leobeo-png/Luminas/README.md

# Luminas
Rhythm game controller development. <br>
[Video Demo](https://www.youtube.com/watch?v=vNHZUSEBsMY "Early Prototype")
[Video Demo](https://www.youtube.com/watch?v=JDYHQ-9xTno "Prototype Update")
---
## Description
 - Custom keyboard NKRO HID 
 - PCB size for 15.6" laptop
 - Separate I2C Bus for the capacitive touch and time of flight to reduce load
---
## Components Used:
 - STM32F411CEU6
 - MPR121 Modules x3
 - VL53L0X ToF sensors x2 (x4 in the future)
 - TCA9548 I2C Multiplexer
 - Pull-up resistors
---
## Goals
 - Improve the design of the PCB 
 - Reaserch and design the casing
--- 
## What I Learnt so Far 
 - HID (descriptors, how NKRO works)
 - PCB schematic designing
 - Diving further into I2C
