leobeo-png/Luminas/sch/sch.kicad_pcb

## KiCad design sch/sch.kicad_pcb (2026-06-11)

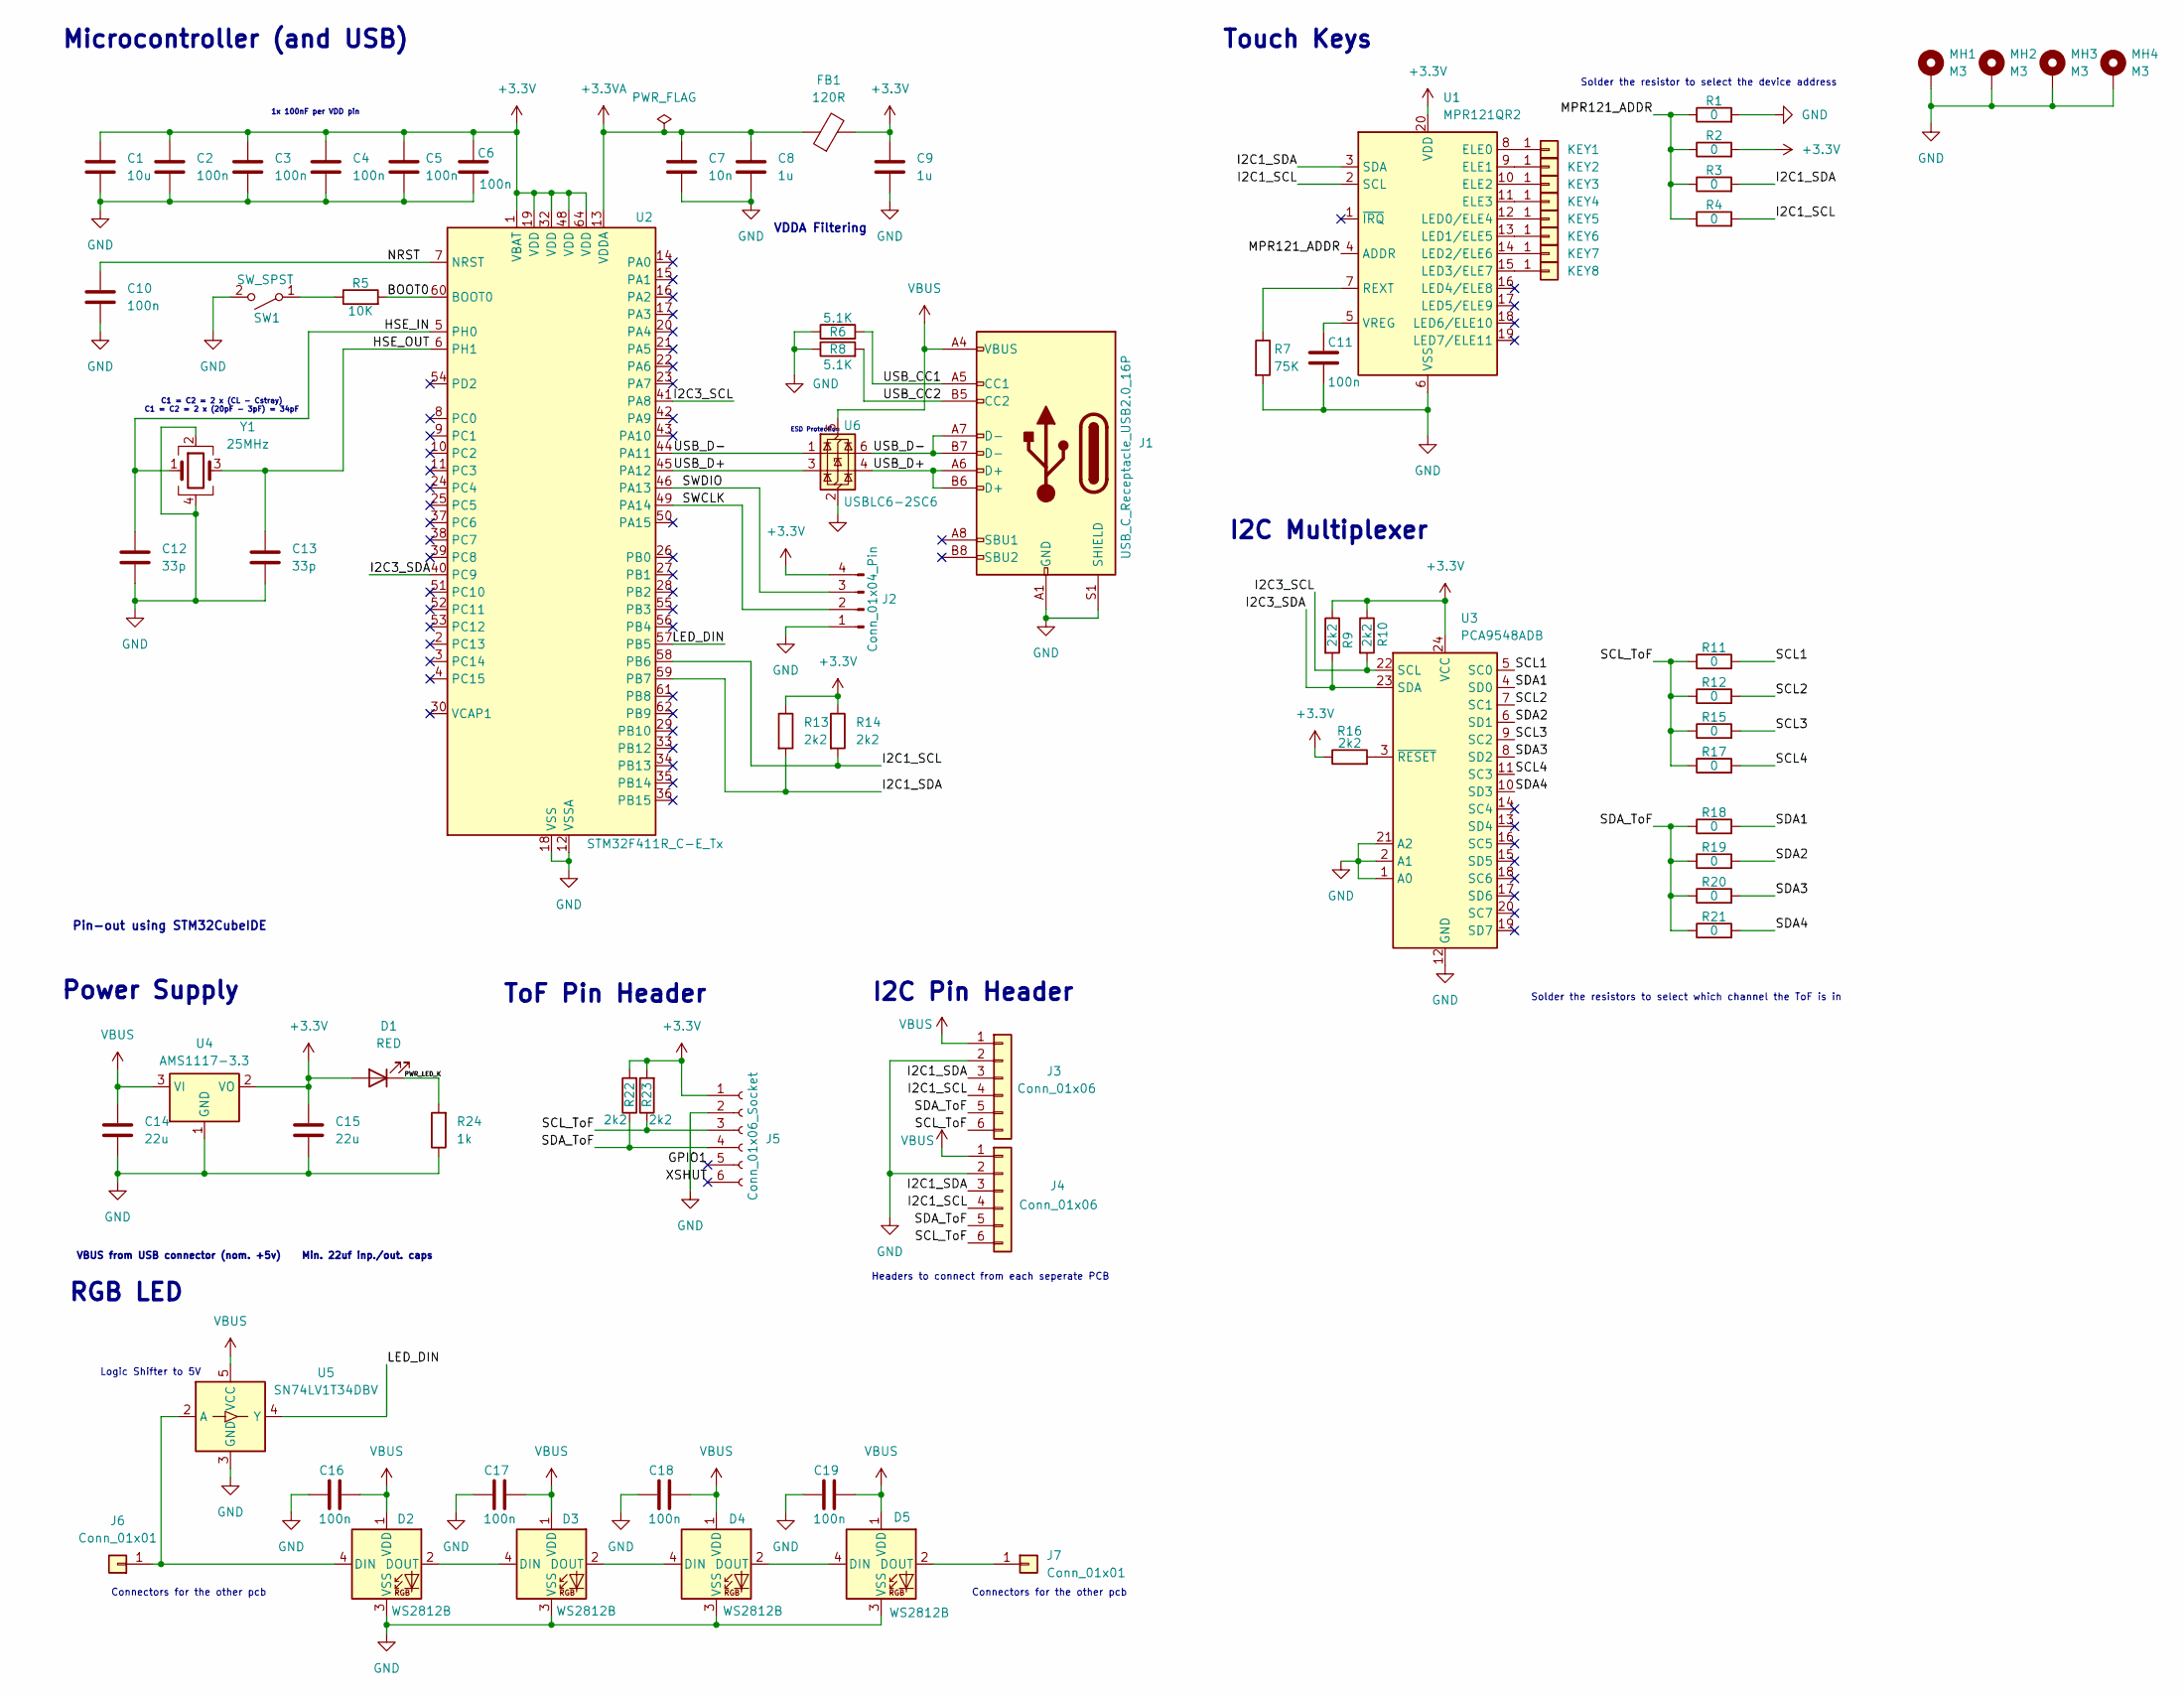
[picture p1: schematic sch.kicad_sch, Chunithm_Luminas]

Parts:
C1: 10u; C_0603_1608Metric_Pad1.08x0.95mm_HandSolder
C2, C3, C4, C5, C6, C10, C11, C16, C17, C18, C19: 100n; C_0603_1608Metric_Pad1.08x0.95mm_HandSolder
C7: 10n; C_0603_1608Metric_Pad1.08x0.95mm_HandSolder
C8, C9: 1u; C_0603_1608Metric_Pad1.08x0.95mm_HandSolder
C12, C13: 33p; C_0603_1608Metric_Pad1.08x0.95mm_HandSolder
C14, C15: 22u; C_0805_2012Metric
D1: RED; LED_0201_0603Metric
D2, D3, D4, D5: WS2812B; LED_WS2812B_PLCC4_5.0x5.0mm_P3.2mm
FB1: 120R; L_0603_1608Metric
J1: USB_C_Receptacle_USB2.0_16P; USB_C_Receptacle_GCT_USB4105-xx-A_16P_TopMnt_Horizontal
J2: Conn_01x04_Pin; PinHeader_1x04_P2.54mm_Vertical
J3, J4: Conn_01x06; Conn_Solder_I2C
J5: Conn_01x06_Socket; PinHeader_1x06_P2.54mm_Vertical
J6, J7: Conn_01x01; Solder_3P
KEY1, KEY2, KEY3, KEY4, KEY5, KEY6, KEY7, KEY8: Conn_01x01; ChuKey
MH1, MH2, MH3, MH4: M3; MountingHole_3.2mm_M3_Pad_Via
R1, R2, R3, R4, R11, R12, R15, R17, R18, R19, R20, R21: 0; R_0603_1608Metric_Pad0.98x0.95mm_HandSolder
R5: 10K; R_0603_1608Metric_Pad0.98x0.95mm_HandSolder
R6, R8: 5.1K; R_0603_1608Metric_Pad0.98x0.95mm_HandSolder
R7: 75K; R_0603_1608Metric_Pad0.98x0.95mm_HandSolder
R9, R10, R13, R14, R16, R22, R23: 2k2; R_0603_1608Metric_Pad0.98x0.95mm_HandSolder
R24: 1k; R_0603_1608Metric_Pad0.98x0.95mm_HandSolder
SW1: SW_SPST; SW_SPST_TS-1088-xR025
U1: MPR121QR2; UQFN-20_3x3mm_P0.4mm
U2: STM32F411R_C-E_Tx; LQFP-64_10x10mm_P0.5mm
U3: PCA9548ADB; TSSOP-24_4.4x7.8mm_P0.65mm
U4: AMS1117-3.3; SOT-223-3_TabPin2
U5: SN74LV1T34DBV; SOT-23-5
U6: USBLC6-2SC6; SOT-23-6
Y1: 25MHz; Crystal_SMD_3225-4Pin_3.2x2.5mm_HandSoldering

Connections:
+3.3V: C1.1, C2.1, C3.1, C4.1, C5.1, C6.1, C9.1, C15.1, D1.2 (A), FB1.2, J2.4, J5.1, R2.2, R9.1, R10.1, R13.1, R14.1, R16.1, R22.2, R23.2, U1.20 (VDD), U2.1 (VBAT), U2.19 (VDD), U2.32 (VDD), U2.48 (VDD), U2.64 (VDD), U3.24 (VCC), U4.2 (VO)
+3.3VA: C7.1, C8.1, FB1.1, U2.13 (VDDA)
/BOOT0: R5.2, U2.60 (BOOT0)
/GPIO1: J5.5
/HSE_IN: C12.1, U2.5 (PH0), Y1.1
/HSE_OUT: C13.1, U2.6 (PH1), Y1.3
/I2C1_SCL: J3.4, J4.4, R4.2, R14.2, U1.2 (SCL), U2.58 (PB6)
/I2C1_SDA: J3.3, J4.3, R3.2, R13.2, U1.3 (SDA), U2.59 (PB7)
/I2C3_SCL: R10.2, U2.41 (PA8), U3.22 (SCL)
/I2C3_SDA: R9.2, U2.40 (PC9), U3.23 (SDA)
/LED_DIN: U2.57 (PB5), U5.4 (Y)
/MPR121_ADDR: R1.1, R2.1, R3.1, R4.1, U1.4 (ADDR)
/NRST: C10.1, U2.7 (NRST)
/PWR_LED_K: D1.1 (K), R24.2
/SCL1: R11.2, U3.5 (SC0)
/SCL2: R12.2, U3.7 (SC1)
/SCL3: R15.2, U3.9 (SC2)
/SCL4: R17.2, U3.11 (SC3)
/SCL_ToF: J3.6, J4.6, J5.3, R11.1, R12.1, R15.1, R17.1, R23.1
/SDA1: R18.2, U3.4 (SD0)
/SDA2: R19.2, U3.6 (SD1)
/SDA3: R20.2, U3.8 (SD2)
/SDA4: R21.2, U3.10 (SD3)
/SDA_ToF: J3.5, J4.5, J5.4, R18.1, R19.1, R20.1, R21.1, R22.1
/SWCLK: J2.2, U2.49 (PA14)
/SWDIO: J2.3, U2.46 (PA13)
/USB_CC1: J1.A5 (CC1), R6.2
/USB_CC2: J1.B5 (CC2), R8.2
/USB_D+: J1.A6 (D+), J1.B6 (D+), U2.45 (PA12), U6.3 (I/O2), U6.4 (I/O2)
/USB_D-: J1.A7 (D-), J1.B7 (D-), U2.44 (PA11), U6.1 (I/O1), U6.6 (I/O1)
/XSHUT: J5.6
GND: C1.2, C2.2, C3.2, C4.2, C5.2, C6.2, C7.2, C8.2, C9.2, C10.2, C11.2, C12.2, C13.2, C14.2, C15.2, C16.1, C17.1, C18.1, C19.1, D2.3 (VSS), D3.3 (VSS), D4.3 (VSS), D5.3 (VSS), J1.A1 (GND), J1.A12 (GND), J1.B1 (GND), J1.B12 (GND), J1.S1 (SHIELD), J2.1, J3.2, J4.2, J5.2, MH1.1, MH2.1, MH3.1, MH4.1, R1.2, R6.1, R7.2, R8.1, R24.1, SW1.2 (B), U1.6 (VSS), U2.12 (VSSA), U2.18 (VSS), U2.31 (VSS), U2.47 (VSS), U2.63 (VSS), U3.1 (A0), U3.2 (A1), U3.12 (GND), U3.21 (A2), U4.1 (GND), U5.3 (GND), U6.2 (GND), Y1.2, Y1.4
unnamed: D2.4 (DIN), J6.1, U5.2 (A)
unnamed: D2.2 (DOUT), D3.4 (DIN)
unnamed: D3.2 (DOUT), D4.4 (DIN)
unnamed: D4.2 (DOUT), D5.4 (DIN)
unnamed: D5.2 (DOUT), J7.1
unnamed: KEY1.1, U1.8 (ELE0)
unnamed: KEY2.1, U1.9 (ELE1)
unnamed: KEY3.1, U1.10 (ELE2)
unnamed: KEY4.1, U1.11 (ELE3)
unnamed: KEY5.1, U1.12 (LED0/ELE4)
unnamed: KEY6.1, U1.13 (LED1/ELE5)
unnamed: KEY7.1, U1.14 (LED2/ELE6)
unnamed: KEY8.1, U1.15 (LED3/ELE7)
unnamed: R5.1, SW1.1 (A)
unnamed: R7.1, U1.7 (REXT)
unnamed: C11.1, U1.5 (VREG)
unnamed: R16.2, U3.3 (~RESET)
VBUS: C14.1, C16.2, C17.2, C18.2, C19.2, D2.1 (VDD), D3.1 (VDD), D4.1 (VDD), D5.1 (VDD), J1.A4 (VBUS), J1.A9 (VBUS), J1.B4 (VBUS), J1.B9 (VBUS), J3.1, J4.1, U4.3 (VI), U5.5 (VCC), U6.5 (VBUS)

Notes on the sheet:
Connectors for the other pcb
I2C Multiplexer
Solder the resistors to select which channel the ToF is in
VBUS from USB connector (nom. +5v) Min. 22uf inp./out. caps
Headers to connect from each seperate PCB
Microcontroller (and USB)
ESD Protection
VDDA Filtering
RGB LED
1x 100nF per VDD pin
I2C Pin Header
Solder the resistor to select the device address
Power Supply
Logic Shifter to 5V
Pin-out using STM32CubeIDE
Touch Keys
ToF Pin Header
C1 = C2 = 2 x (CL - Cstray) C1 = C2 = 2 x (20pF - 3pF) = 34pF

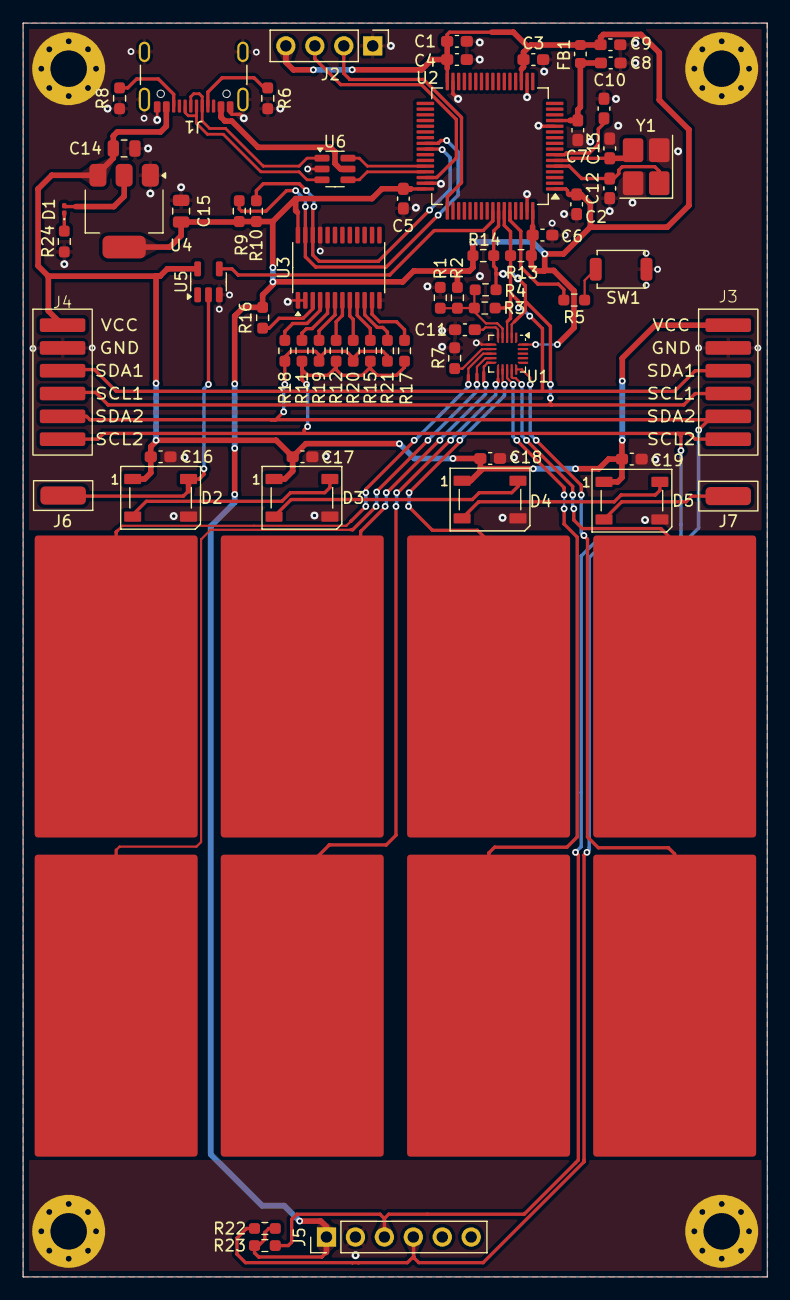
[picture p2: board sch.kicad_pcb from above]

Board: 2 copper layers, 65.3 x 110.0 mm, 76 parts (0 on the bottom side), 48 nets.
