leobeo-png/Luminas/stm32/MPR_GP2Y/MPR_GP2Y.ioc

Mcu.UserName=STM32F411CEUx
PA11.Signal=USB_OTG_FS_DM
PA12.Signal=USB_OTG_FS_DP
PA5.Signal=ADCx_IN5
PA6.Signal=ADCx_IN6
PB6.Signal=I2C1_SCL
PB7.Signal=I2C1_SDA
