leobeo-png/Luminas/stm32/MPR_GP2Y/Core/Src/main.c

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
/* Includes ------------------------------------------------------------------*/
#include "main.h"
#include "usb_device.h"

/* USER CODE BEGIN Includes */
#include "mpr121_handler.h"
#include "gp2y.h"
/* USER CODE END Includes */

ADC_HandleTypeDef hadc1;
DMA_HandleTypeDef hdma_adc1;

I2C_HandleTypeDef hi2c1;

/* USER CODE BEGIN PV */
extern uint32_t adc_buf[];
/* USER CODE END PV */

void SystemClock_Config(void);
static void MX_GPIO_Init(void);
static void MX_DMA_Init(void);
static void MX_ADC1_Init(void);
static void MX_I2C1_Init(void);
/**
  * @brief  The application entry point.
  * @retval int
  */
int main(void)
{

  /* MCU Configuration--------------------------------------------------------*/

  /* Reset of all peripherals, Initializes the Flash interface and the Systick. */
  HAL_Init();

  /* Configure the system clock */
  SystemClock_Config();

  /* Initialize all configured peripherals */
  MX_GPIO_Init();
  MX_DMA_Init();
  MX_ADC1_Init();
  MX_I2C1_Init();
  MX_USB_DEVICE_Init();
  /* USER CODE BEGIN 2 */
  //HAL_ADCEx_Calibration_start(&hadc1, ADC_CALIB_OFFSET, ADC_SINGLE_ENDED);

  GP2Y_Init();
  HAL_Delay(100);
  MPR121_Handler_Init();
  /* USER CODE END 2 */

  /* Infinite loop */
  /* USER CODE BEGIN WHILE */
  while (1)
  {
    /* USER CODE END WHILE */

    /* USER CODE BEGIN 3 */

//	  HAL_Delay(3000);  // give USB time to enumerate
//
//	  NKRO_PressKey(0x04);   // 'A'
//	  NKRO_SendReport();
//	  HAL_Delay(100);
//
//	  NKRO_ReleaseKey(0x04);
//	  NKRO_SendReport();

	  MPR121_Handler_Process();
	  GP2Y_Process();
	  NKRO_SendReport();

  }
  /* USER CODE END 3 */
}

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
