leobeo-png/Luminas/stm32/MPR_GP2Y/Core/Inc/gp2y.h

/*
 * gp2y.h
 *
 *  Created on: Apr 19, 2026
 *      Author: leoar
 */

#ifndef INC_GP2Y_H_
#define INC_GP2Y_H_

#include "hid_nkro.h"

void GP2Y_Init(void);
void GP2Y_Process(void);

#endif /* INC_GP2Y_H_ */
