leobeo-png/Luminas/stm32/try1/Core/Inc/sensor_detection.h

/*
* sensor_detection.h
*
* Created on: Oct 13, 2025
* Author: leoar
*/

#ifndef SENSOR_DETECTION_H_
#define SENSOR_DETECTION_H_

#include "main.h"
#include "usbd_customhid.h"
#include "mpr121.h"
#include "tca9548.h"
#include "vl53l0x_stm32.h"
#include <stdint.h>
#include <stdbool.h>

// External USB device handle (defined in usb_device.c or usbd_conf.c)
extern USBD_HandleTypeDef hUsbDeviceFS;

// External MPR121 instance
extern MPR121_t cap1;
extern MPR121_t cap2;
extern MPR121_t cap3;
extern TCA9548A_HandleTypeDef tca9548;



// Sensor detection public functions
void initSensorDetection(void);
void updateSensorDetection(void);
void processTouchSensors(void);
void processToFSensors(void);
void sendHIDReport(void);
uint8_t mapDistance(uint16_t d);

#endif /* SENSOR_DETECTION_H_ */
