leobeo-png/Luminas/(commit log)

2024-11-06 First Itteration
    This version includes working NKRO and ToF. Although it might
    occasionally crash, probably because of memory? But i still don't know.
    [Chunithm_1.ino, mpr121.h]
2024-11-06 Update README.md
    Updated it to its current state
2025-04-01 Added Schematics and updated title
    [sch.kicad_pcb, sch.kicad_sch]
2025-05-05 Updated PCB
    [sch.kicad_pcb, sch.kicad_sch]
2025-05-05 ATMEGA32U4 option
    [ATMEGA32U4-AU.step]
2025-05-07 Working code for the prototype board
2025-05-07 Updated schematic for Pro Micro
    [sch.kicad_pcb, sch.kicad_sch]
2025-10-13 improvements for first prototype
    added 3 mpr121 support, haven't figured out crashing issue
2025-10-15 STM32F411CEU6 Implementation
    ported the code into stm32 platform for more robustness on the i2c bus.
2026-02-11 fixed missing pull up on multiplexer
    [sch.kicad_pcb, sch.kicad_sch]
2026-03-02 Revision 2 of the PCB
    Updated to using stm32f4 and a more modular design
    [ATMEGA32U4-AU.step, sch.kicad_pcb, sch.kicad_sch]
2026-03-27 Updated side pads with power and ground
    [sch.kicad_pcb, sch.kicad_sch]
2026-06-11 gpy2 sensor instead of tof
    [sch.kicad_pcb]
