leobeo-png/Luminas/(notices)

Notices in the files:
stm32/MPR_GP2Y/Core/Src/main.c:
Copyright (c) 2026 STMicroelectronics.
All rights reserved.
This software is licensed under terms that can be found in the LICENSE file
